UTHT/pod1-electronics-pcbs/README.md

# UTHT Pod 1 - Electronics PCBs

Printed circuit board designs for UTHT Pod 1. Made in Fusion 360.
