UTHT/pod1-electronics-pcbs/pcb1/README.md

# PCB 1

## Inputs

- 12VDC (J1)
- 24VDC (J2)

## Sensors

- ProSense RTD0100-06-010-H Temperature Probe (J3)
- 2x ProSense SPT25-20-0200A Pressure Transmitter (J4, J5)
- ProSense SPTD25-20-1000H Pressure Transmitter (J6)
- Adafruit TMP006 Infrared Thermopile Breakout Board (J7)
- VectorNav VN-200 9-Axis GNSS/INS (J8)
