UTHT/pod1-electronics-pcbs/pcb2/README.md

# PCB 2

## Inputs

- 12VDC (J1)
- 24VDC (J2)

## Sensors

- Wenglor OPT2002 Optical Distance Sensor (J3)
- AcuAMP DCT500-42-24-F DC Current Sensor (J4)
