UTHT/pod1-electronics-pcbs/pcb3/README.md

# PCB 3

## Inputs

- 12VDC (J1)
- 24VDC (J2)

## Sensors

- 2x ProSense RTD0100-06-010-H Temperature Probe (J3, J4)
- ProSense VFS50-5-1001 Liquid Flow Sensor (J5)

## Actuators

- Inverter Discharge Relay (J6)
- Braking Solenoid (J7)
- Serial-CAN Bus Converter (J8)
