UTHT/pod1-electronics-pcbs/pcb1/assets/pcb1_brd.png

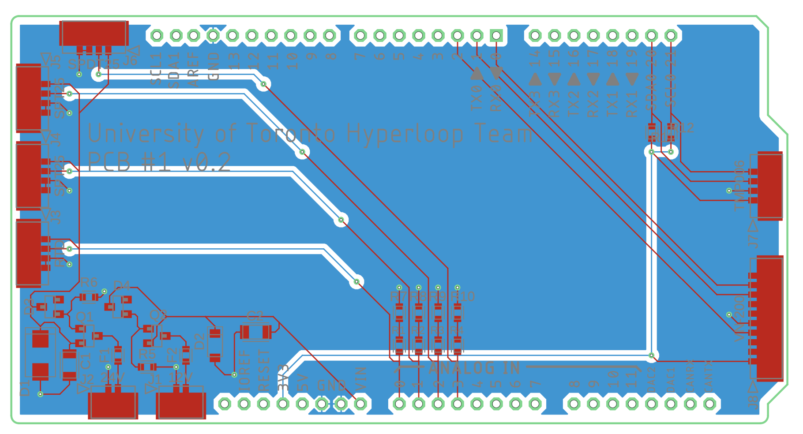
pcb1/assets/pcb1_brd.png
