UTHT/pod1-electronics-pcbs/pcb1/assets/pcb1_model_front.png

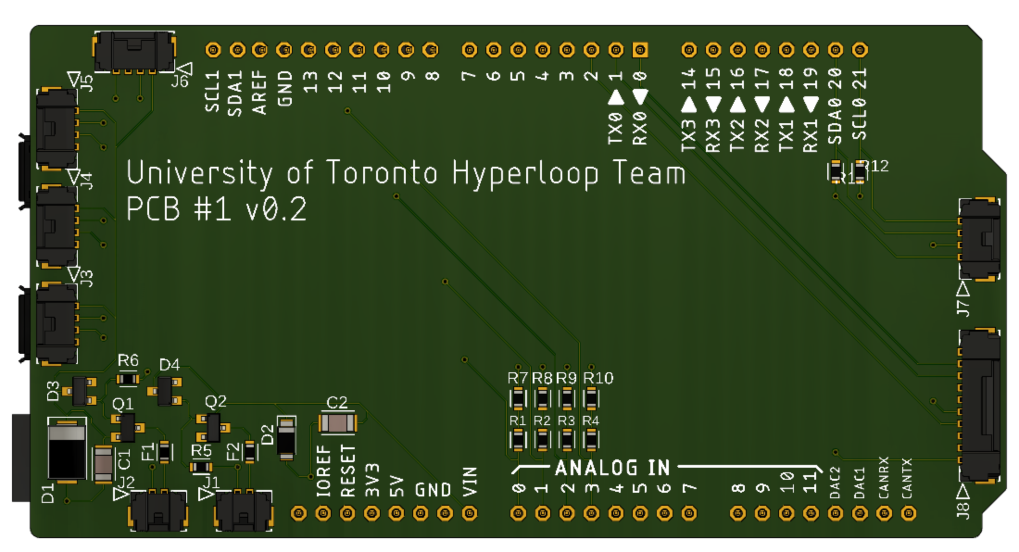
pcb1/assets/pcb1_model_front.png
