UTHT/pod1-electronics-pcbs/pcb1/assets/pcb1_model_home.png

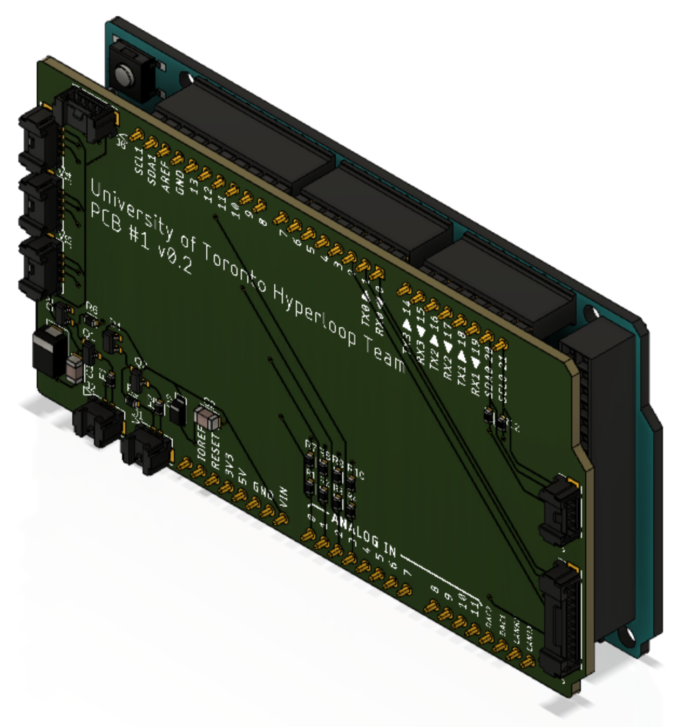
pcb1/assets/pcb1_model_home.png
