UTHT/pod1-electronics-pcbs/pcb1/assets/pcb1_sch.png

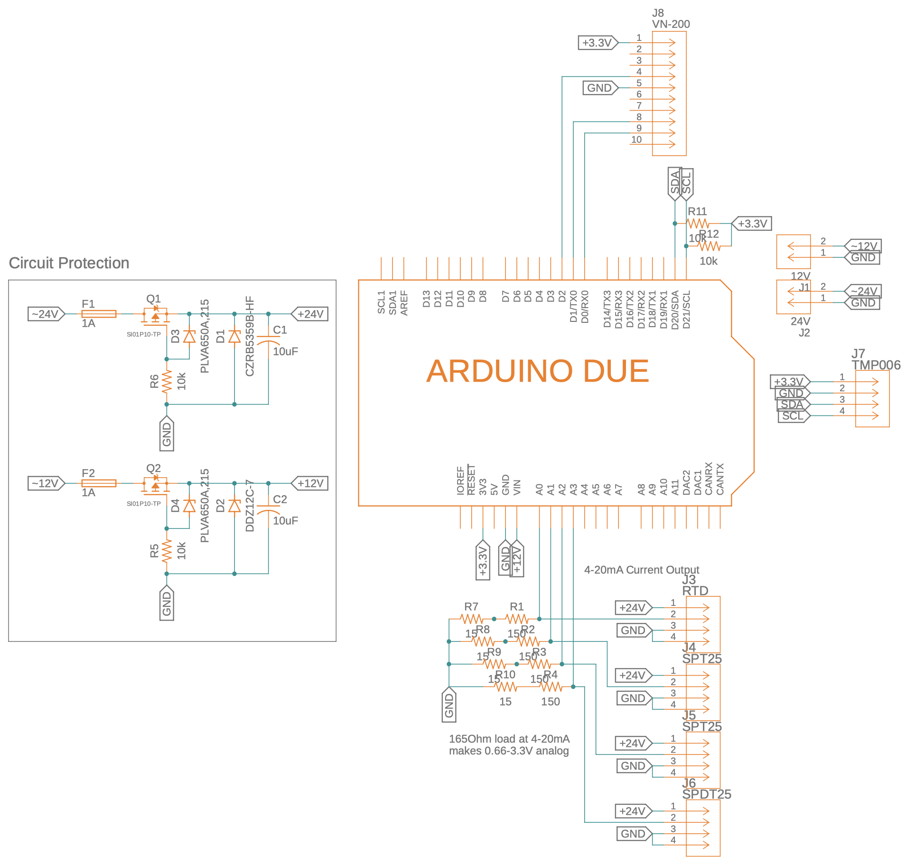
pcb1/assets/pcb1_sch.png
