UTHT/pod1-electronics-pcbs/pcb2/assets/pcb2_brd.png

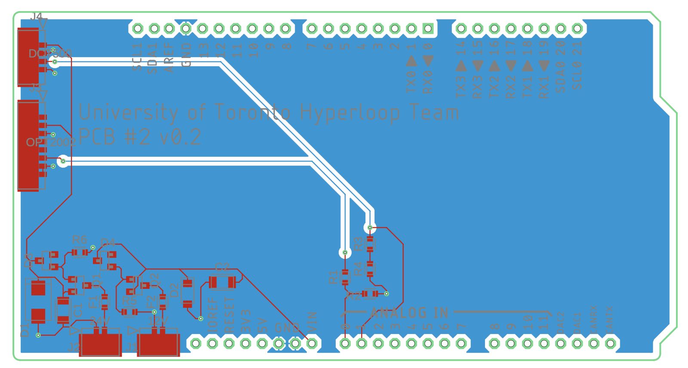
pcb2/assets/pcb2_brd.png
