UTHT/pod1-electronics-pcbs/pcb2/assets/pcb2_model_home.png

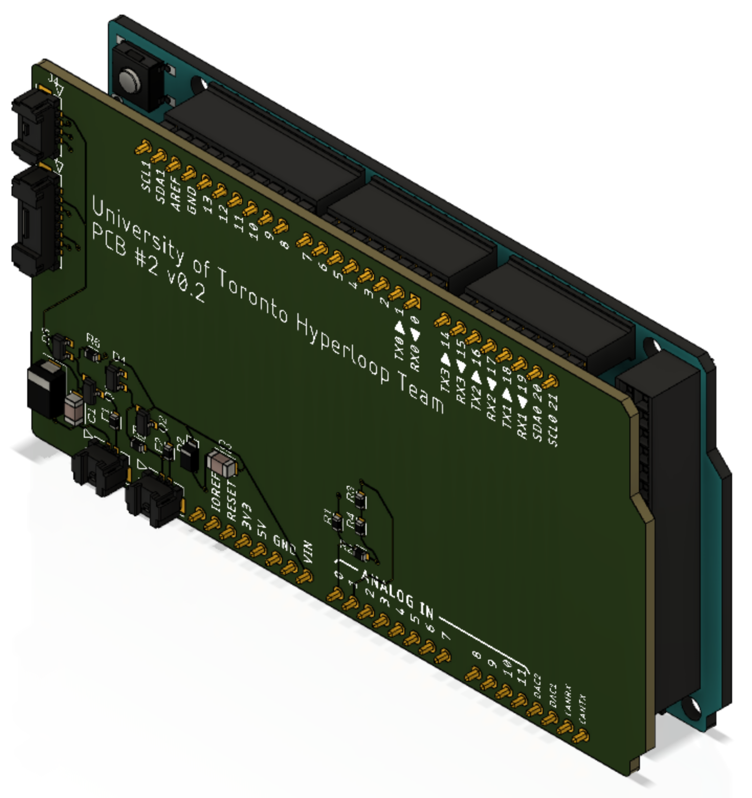
pcb2/assets/pcb2_model_home.png
