UTHT/pod1-electronics-pcbs/pcb2/assets/pcb2_sch.png

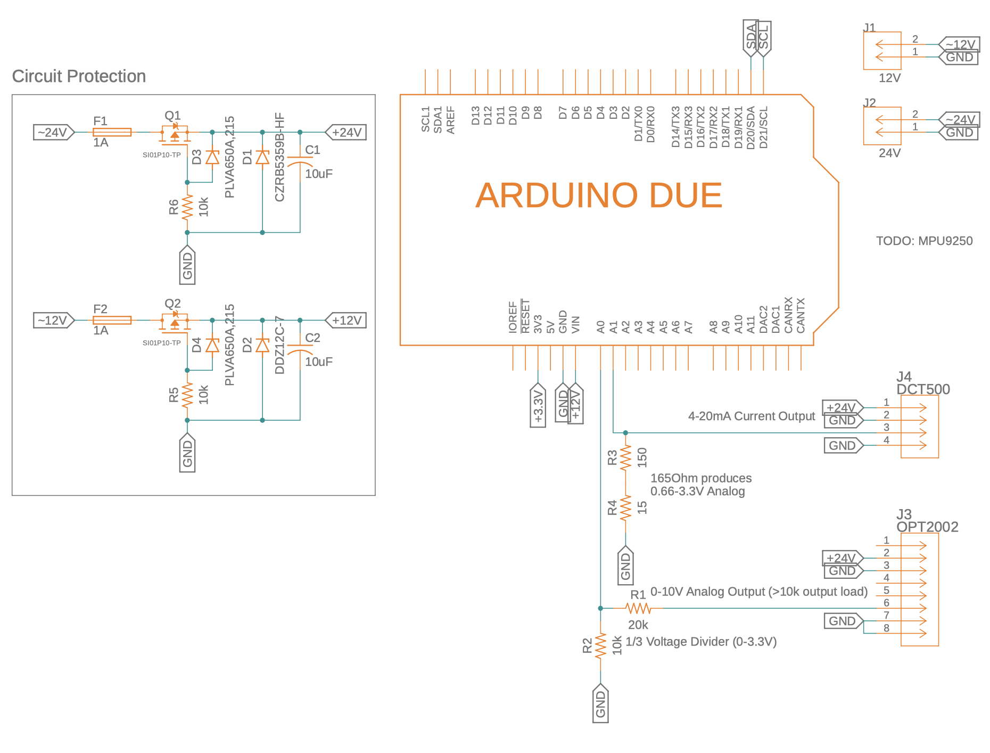
pcb2/assets/pcb2_sch.png
