UTHT/pod1-electronics-pcbs/pcb3/assets/pcb3_brd.png

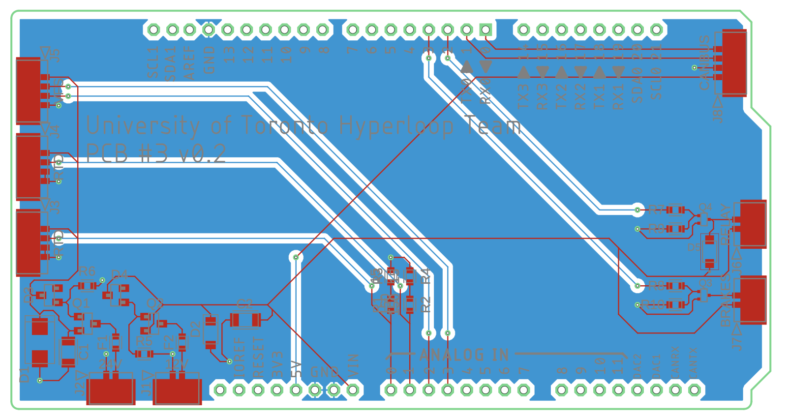
pcb3/assets/pcb3_brd.png
