UTHT/pod1-electronics-pcbs/pcb3/assets/pcb3_model_front.png

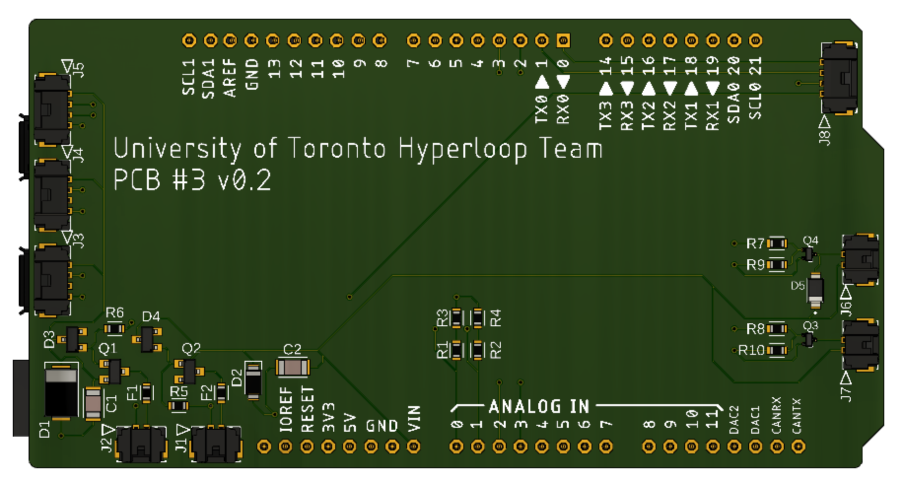
pcb3/assets/pcb3_model_front.png
