UTHT/pod1-electronics-pcbs/pcb3/assets/pcb3_sch.png

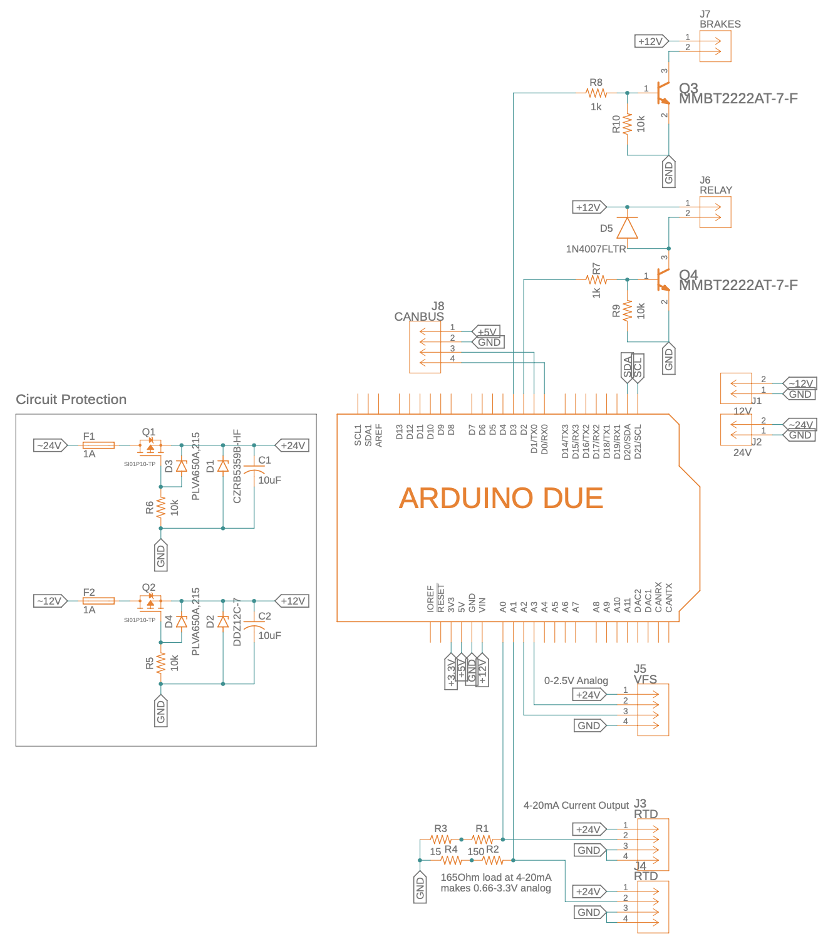
pcb3/assets/pcb3_sch.png
