UTHT/pod1-electronics-pcbs/pcb2/pcb2.brd

## EAGLE design pcb2/pcb2.brd (2022-06-11)

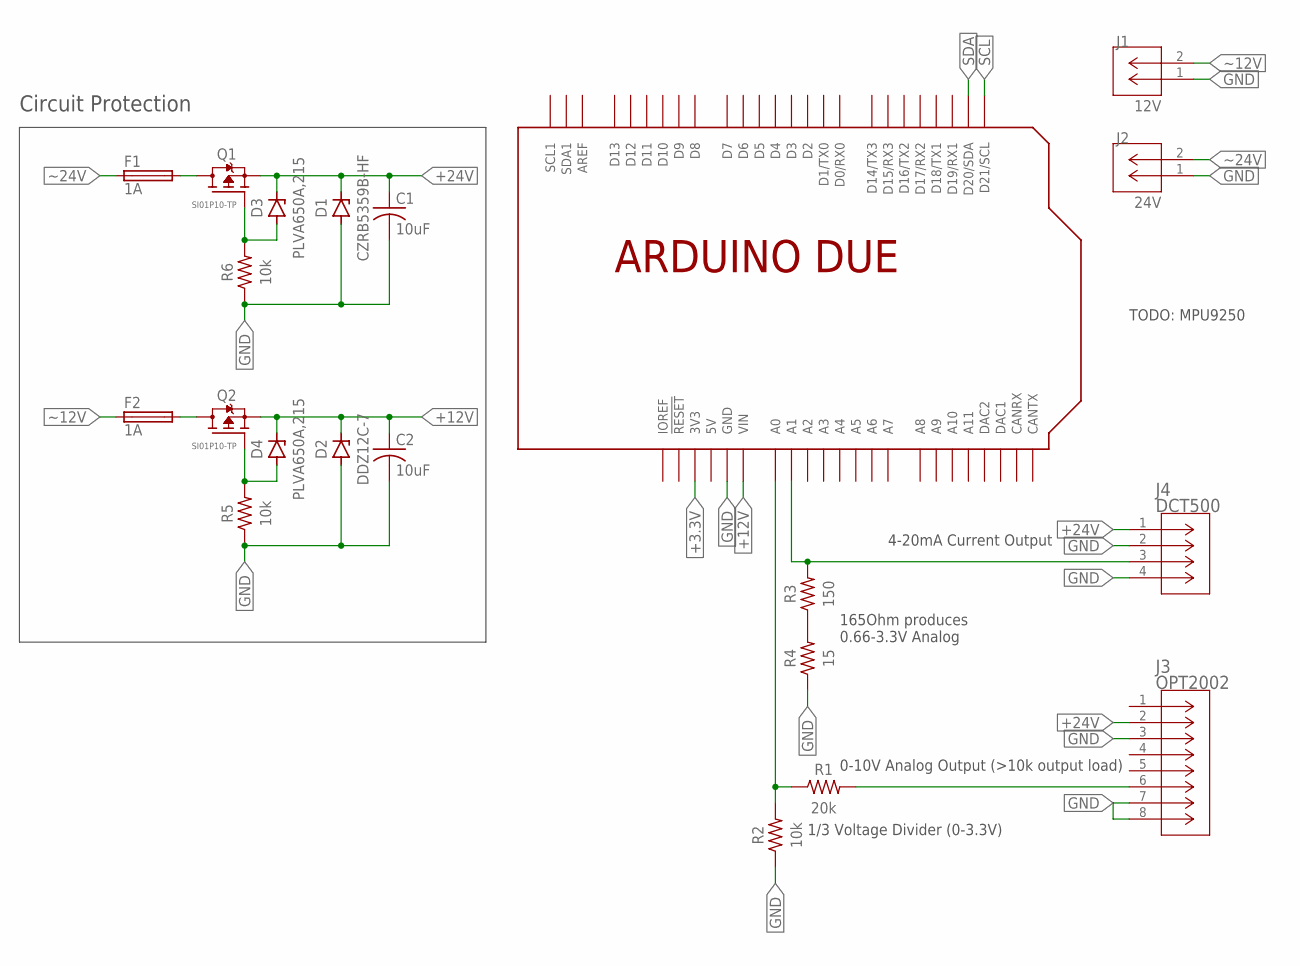
[picture p12: schematic pcb2.sch]

Parts:
C1, C2: 10uF; CAPC3216X135
D1: CZRB5359B-HF; DIOM5336X265N
D2: DDZ12C-7; SODFL3718X115
D3, D4: PLVA650A,215; SOT23
F1, F2: 1A; FUSC1608X60N
J1: 12V; 2PIN
J2: 24V; 2PIN
J3: OPT2002; 8PIN
J4: DCT500; 4PIN
Q1, Q2: SI01P10-TP; SOT23
R1: 20k; RESC1608X60
R2, R5, R6: 10k; RESC1608X60
R3: 150; RESC1608X60
R4: 15; RESC1608X60
U$1: ARDUINODUE_MIN_NOHOLES

Connections:
5V: U$1.5V
+3.3V: U$1.3V3
+12V: C2.1, D2.1 (C), D4.3 (C), Q2.2 (S), U$1.VIN
+24V: C1.1, D1.1 (C), D3.3 (C), J3.2, J4.1, Q1.2 (S)
GND: C1.2, C2.2, D1.2 (A), D2.2 (A), J1.1 (2), J2.1 (2), J3.3, J3.7, J3.8, J4.2, J4.4, R2.1, R4.1, R5.1, R6.1, U$1.GND, U$1.GND1 (GND), U$1.GND2 (GND)
unnamed: J3.6, R1.2
unnamed: R1.1, R2.2, U$1.A0
unnamed: J4.3, R3.2, U$1.A1
unnamed: R3.1, R4.2
unnamed: D3.1 (A), Q1.1 (G), R6.2
unnamed: D4.1 (A), Q2.1 (G), R5.2
unnamed: F2.2, Q2.3 (D)
unnamed: F1.2, Q1.3 (D)
SCL: U$1.D21 (D21/SCL)
SDA: U$1.D20 (D20/SDA)
~12V: F2.1, J1.2 (3)
~24V: F1.1, J2.2 (3)

Notes on the sheet:
Circuit Protection
0-10V Analog Output (>10k output load)
1/3 Voltage Divider (0-3.3V)
4-20mA Current Output
165Ohm produces 0.66-3.3V Analog
TODO: MPU9250

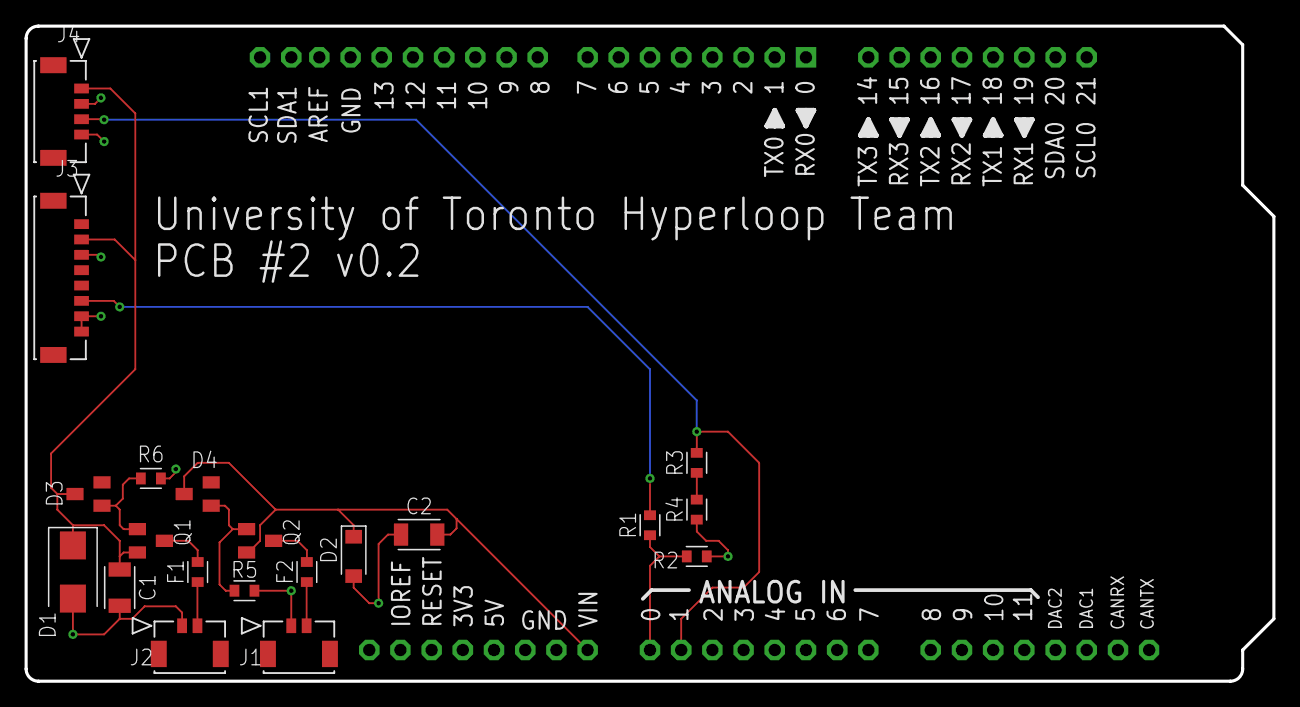
[picture p13: board pcb2.brd from above]

Board: 2 copper layers, 101.6 x 53.3 mm, 21 parts (0 on the bottom side), 13 nets.
