UTHT/pod1-electronics-pcbs/(threads)

Thread 1 (2022-01-13):

Re-Fix Old Issues

JLefebvre55, 2022-01-13:
- Add board outline to mechanical layer
- Add PCB silkscreen text

Closed 2022-03-15.
