UTHT/pod1-electronics-pcbs/(commit log)

2022-01-13 V0.1 Upload
    [PCB1.PcbDoc, PCB1_schematic.SchDoc, PCB2_Schematic.SchDoc, PCB2_v2.PcbDoc, PCB_3.PcbDoc, PCB_3.SchDoc, Protection Circuit 12V.SchDoc, Protection Circuit 24V.SchDoc]
2022-03-05 BoM CSVs
    DigiKey-compatible BoM CSVs
    [bom_components_pcb1.csv, bom_components_pcb2.csv, bom_components_pcb3.csv]
2022-03-06 Updated voltage and sensor info
2022-03-07 Board, Schematic Assets
    All 3 PCBs, also protection circuit schematics
2022-03-08 Minor Fix
    [bom_components_pcb1.csv]
2022-03-14 UTHT PCBs V0.2
    * Migrated to Fusion 360
    * Changed all connectors to Molex Micro-Lock PLUS
    + Relay flyback diode
    * Changed relay, solenoid MOSFETs to NPN
    * Much better shield board outline and layout
    * Better pull-down resistor values
    * New BoMs, schematics, layouts, and pictures
    - Protection circuits no longer modularized
    [PCB1.PcbDoc, PCB1_schematic.SchDoc, PCB2_Schematic.SchDoc, PCB2_v2.PcbDoc, PCB_3.PcbDoc, PCB_3.SchDoc, Protection Circuit 12V.SchDoc, Protection Circuit 24V.SchDoc]
2022-03-15 Documentation Updates
    * Updated Readmes
    * Rotated sch, brd pictures
    - Removed old protection circuit pictures
2022-04-01 Add Serial CAN Bus to PCB 3
    [pcb3.brd, pcb3.sch]
2022-04-01 Changed TMP006 Connection
    * changed tmp006 connection to molex 4pin
    + Added SDA/SCL pullup resistors
    [pcb1.brd, pcb1.sch, pcb1_components_bom.csv, pcb3_components_bom.csv]
2022-04-01 Gerber Files
    [copper_bottom.gbr, copper_top.gbr, drill_1_16.xln, gerber_job.gbrjob, profile.gbr, silkscreen_bottom.gbr, silkscreen_top.gbr, soldermask_bottom.gbr]
