UTHT/pod1-electronics-pcbs/(notices)

Notices in the files:
parts and their libraries:
Molex Micro-Lock PLUS: COPYRIGHT: Copyright (C) 2022 Ultra Librarian. All rights reserved.
